galjonsfigur/gainer/README.md

GAINER
======

Software and hardware design resources for a sensor I/O module made
by Shigeru Kobayashi Takanori Endo Katsuhiko Harada and Shosei Oishi.

Contains:

- CY8C29466 PSoC GAINER firmware source code
- GAINER Flash library + source code
- GAINER Processing library (works only on very old version of Processing software) + source code
- GAINER Max/MSP library + source code
- GAINER PureData library + source code
- GAINER hardware design
- Eagle schematics for various projects
