galjonsfigur/gainer/hardware/gainer_v1/gainer_v1_bom.xls

GAINER I/O module parts list
version | 1.0.0
date | 2006.2.27
 | manufacturer | description | product | specification | part number | price | quantity | subtotal | comments
F1 | Littelfuse Inc | thermister PTC | 1206L025YRT | 15V, 0.25A | F2110CT-ND | 0.70 | 1 | 0.70
L1 | Steward | ferrite chip beads | MI0805K400R-10 | 1.5A, 40ohm | 240-2389-1-ND | 0.88 | 0.1 | 0.09 | 1/10
IC1 | Cypress | microcontroller | CY8C29466-24PXI |  | 428-1586-ND | 8.78 | 1 | 8.78
IC2 | FTDI | USB-to-UART bridge | FT232RL |  | 619-604-00043 (http://www.mouser.com/index.cfm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) | 4.50 | 1 | 4.50 | at Mouser Electronics, Inc.
C1, C4, C5 |  | ceramic capacitor |  | 0.1uF, 50V | 399-4151-ND | 0.16 | 3 | 0.48
C2 |  | ceramic capacitor |  | 0.01uF, 50V | 399-4150-ND | 0.16 | 1 | 0.16
C3 |  | electrolytic capacitor |  | 10uF, 25V | 493-1057-ND | 0.20 | 1 | 0.20
R1, R2 |  | resistor |  | 330ohm, 1/6W | 330EBK-ND | 0.26 | 0.4 | 0.10 | 2/5
LED1, LED2 |  | LED |  | 3mm | HLMP1790-ND | 0.34 | 2 | 0.68 | choose any color as you like :)
S1 | Omron | tact switch | B3F-1005 | 6mm | SW793-ND | 0.28 | 1 | 0.28
X1 |  | USB type B connector |  |  | 151-1081-ND | 0.73 | 1 | 0.73
 |  | IC socket |  | 28pin, 300mil | 571-3902619 | 0.20 | 1 | 0.20 | at Mouser Electronics, Inc.
 |  | single row header |  | 14pin * 2 | 575-101641 | 5.46 | 0.5 | 2.73 | 1/2, at Mouser Electronics, Inc.
PCB |  | PCB board |  | GAINER v1.0.0 |  | 42.00 | 0.167 | 7.00 | 1/6, at OLIMEX Ltd.
 |  |  |  |  |  |  | total | 26.63
NOTES
The price above does not include tax and shipping cost.
