galjonsfigur/gainer/(commit log)

2005-10-22 baseline version for the sourceforge CVS server
    [gainer_v1.brd, gainer_v1.sch]
2005-11-08 modified to add error checking for invalid commands
    [config_a.c, main.c]
2005-11-12 * make pull-down default (was pull-up) for digital inputs * fixed bugs about message analog input (continuous mode)
    [config_a.c]
2005-11-15 modified to fix following bugs: * 'A' commenad doesn't work correctly * order of analog inputs is inverted
    [config_a.c]
2005-11-22 changed drive mode of P1[5] from PullUp to PullDown to fix bug id 1362787
    [bootloaderconfig.asm]
2005-11-22 updated to fix the following bugs
    1362787: bootloader function won't work
    1358730: return charactors for button
2005-11-22 updated to fix the following bugs
    1363485: gainer module accepts broken commands
    1363459: gainer module stop responding at high traffic
    [config_a.c, config_b.c, gainer_common.h, main.c]
2005-11-23 * added WaitForBriefSpells() * reverted default configuration from C0 to C1
    [main.c]
2005-11-30 * changed configuration command from 'Cx' to 'KONFIGURATION_x' * implemented configuration 2 and 3 * modified PWM configuration * minor code fixing
    [config_a.c, config_b.c, gainer_common.h, main.c]
2005-12-01 * moved GET_DIN_* and SET_DOUT_* from gainer_common.h * fixed bug about 'i' command
    [config_a.c]
2005-12-08 this will be the second trial
    [gainer_v1.brd, gainer_v1.sch]
2005-12-10 modified the width of the polygon for the copper pour from 0 mils to 10 mils
    since made with 0 mils line width Eagle creates enormous useless gerbers
    (from OLIMEX)
    [gainer_v1.brd]
2005-12-10 * fixed isolate value of copper pour to 10 mils * modified silk a little bit
    [gainer_v1.brd, gainer_v1.sch]
2005-12-12 * added verbose mode * added config 4 (ain = 8, aout = 8) * changed PWM freq of config_a from 50Hz to 1000Hz
2005-12-12 added configuration 7 and 8 * configuration 7 is not implemented * configuration 8 has bugs...
    [config_c.c, config_d.c, gainer_common.h, main.c]
2005-12-16 * implemented 4 CapSense inputs * fixed bugs of the previous version
    [config_d.c]
2005-12-19 implemented configuration 7 (LED matrix control)
2006-01-03 modified to use FTDI FT232RL
    [gainer_v1.brd, gainer_v1.sch]
2006-01-04 updated for OLIMEX
    [gainer_v1.brd]
2006-01-14 updated a little bit for OLIMEX
    [gainer_v1.sch]
2006-01-18 modified to use passive devices instead of surface mount devices
    [gainer_v1.brd, gainer_v1.sch]
2006-01-31 modified to use passive components
    [gainer_v1.brd, gainer_v1.sch]
2006-02-06 modified silks and patterns a little bit for v1.00
    [gainer_v1.brd, gainer_v1.sch]
2006-02-20 updated for v1.0.0/8 * replaced software reset with just changing configuration * added '?' command to support version check
    [main.c]
2006-03-01 modified to handle very short pulse for analog inputs
    [config_a.c, main.c]
2006-03-02 modified to do UART_bErrCheck() to check Rx buffer
2006-03-07 modified to fix the following bug: [1441410] I/O module stop working after sending 'Q' in C8
    [config_d.c]
2006-03-13 modified to fix the following bug: [1448584] I/O module drops subsequent commands http://sourceforge.net/tracker/index.php?func=detail&aid=1448584&group_id=147670&atid=769110
    special thanks to Ganesh:
    http://www.psocdeveloper.com/forums/viewtopic.php?p=8582
    [config_a.c]
2006-03-14 + implemented 'adin sampling mode'
    + modified to reduce total binary size
    * replace 'switch-case' with 'if'
    * unified duplicated code portions
    [config_a.c]
2006-03-15 baseline version for CVS
    [gainer_v1_bom.xls]
2006-03-15 added description about 'M' command
    [io-module_protocol.xls]
2006-03-15 + fixed the following bug: [1450108] dout won't work in config 1 and 2
    + replaces 'switch-case' statement with 'if-elif' statement to reduce object size
    [config_a.c]
2006-03-15 repleced local implementation to put error strings with PutErrorStringToReplyBuffer()
    [config_b.c, config_c.c]
2006-03-15 + repleced local implementation to put error strings with PutErrorStringToReplyBuffer()
    + implemented 'T' command to change sensitivity for capasitive sensing inputs
    [config_d.c]
2006-03-15 + added 'T' command + added rows to show availability of commands in each configuration
    [io-module_protocol.xls]
2006-03-22 modified to fix a bug about touch sensitivity handling
    [config_d.c]
2006-03-24 modified to do not use non standard drill size (32mil) for OLIMEX Ltd. * C1 * C2 * C4 * C5
    [gainer_v1.brd, gainer_v1.sch]
2006-03-24 added 'GAINER v1'
    [gainer_v1.brd]
2006-03-27 replaced UART_x modules with single UART
    [config_a.c, config_b.c, config_c.c, config_d.c, main.c]
2006-03-30 modified to use a function pointer to main functions instead of using switch-case each time
2006-04-05 added descriptions of basic transactions * configuration * version information query
    [io-module_protocol.xls]
2006-04-17 added description about 'a' command in configuration 7
    [io-module_protocol.xls]
2006-05-15 レポジトリ作り。 基本的に必要そうなファイルを入れてみただけ
2006-05-16 シリアルポートとgainerのブリッジ製作中。 とりあえずガワだけ。
2006-05-17 changed LED brightness value from 8bit to 4bit
2006-05-19 絶賛ガワ工事進行中
2006-05-23 * replaced bContinuousAinRequested with bGetAinRequested * repleced bContinuousAinMask wirh bGetAinChannelMask
    [config_b.c, config_c.c, config_d.c, gainer_common.h]
2006-05-23 * replaced bContinuousAinRequested with bGetAinRequested * repleced bContinuousAinMask wirh bGetAinChannelMask * modified version strings from 1.0.0.14 to 1.0.0.15
    [main.c]
2006-05-23 * replaced bContinuousAinRequested with bGetAinRequested * repleced bContinuousAinMask wirh bGetAinChannelMask * modified handle_ain_event() and send_ain_values()
    [config_a.c]
2006-05-27 modified desrciption of 'a' command for configuration 7 * was 8bit per port * now 4bit per port
    [io-module_protocol.xls]
2006-05-28 Flashライブラリ追加
2006-05-28 package名をgainerに変更
2006-05-28 pdpをgainerにリネーム
2006-05-28 WIN32: Serial sending is OK implemented following methods Verbose configuration LEDOn LEDOff sendSerial
2006-06-11 指定したCOMポートが見つからなかったことを ログに出力
2006-06-14 modified to disconnect PWM8 modules in configuration 1 and 2 to fix the following bug: 0. connect an I/O module 1. enter configuration 1 -> dout 0~3 works 2. reboot by sending 'Q' command 3. enter co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
    [config_a.c]
2006-07-01 エラーメッセージ: specified port was not found... が正常起動時も表示されていた不具合を修正
2006-07-08 コマンド文字列中の16進数を大文字に変更(*.as) 各flaファイルのドキュメントレベルクラスパスの変更(*.fla) swfのリビルド(*.swf)
2006-07-10 Added the new project "funnel" to hardware. The funnel is a code name for a gainer I/O module with wireless connection capability.
    The funnel is consisting of the following key components:
    * CY8C29466-24SXI
    * KC Wirefree KC21 Bluetooth module
    [funnel.sch]
2006-07-26 initial design of the "funnel" i/o module * implemented initial design * added board file (.brd)
    [funnel.brd, funnel.sch]
2006-07-26 modified symbol design to shrink size of the regulator
2006-07-31 updated to do not use airways :)
    special thanks to: genie
    [funnel.brd, funnel.sch]
2006-08-30 ・アナログポートへの出力時に小数点以下切捨て ・ampGainAGND,ampGainDGND追加 ・MODE7とscanLine,scanMatrix追加
2006-08-30 * added bridges folder * added FET_bridge (.sch and .brd)
    [FET_bridge.brd, FET_bridge.sch]
2006-09-04 * modified silk on component side a little bit * added silk on solder side
    [FET_bridge.brd]
2006-09-04 added for GerbMerge to make order (to EzPCB)
    [FET_bridge_layout.cfg]
2006-09-12 scanLineのバグ修正
2006-09-12 8x8LEDマトリックスサンプル Flash8以降
2006-09-13 added experimental modules * RPR-220_board.* * psoc_module.* * power_module.* * bluetooth_module.*
    [RPR-220_board.brd, RPR-220_board.sch, bluetooth_module.brd, bluetooth_module.sch, power_module.brd, power_module.sch, psoc_module.brd, psoc_module.sch]
2006-09-14 Gainerを2つ使用しての16x8LEDMatrixサンプル 要WebCam,Flash8
2006-11-16 added "base" project for baseboard development
    [h-bridge.brd, h-bridge.sch]
2007-01-03 updated a little bit to fit actual pin layout
2007-01-03 updated to save space in schematics
2007-01-03 added cookbook (baseline version)
    [ain0_cds.sch, ain_acceleration_sensor.sch, ain_cds.sch, ain_distance_sensor.sch, ain_pot.sch, aout_dc-motor.sch, aout_full_color_led.sch, aout_led.sch]
2007-01-09 added following files: * custom.* * gainer_api.* * gainer_ports.h
    NOTE: still won't work
    [main.c]
2007-01-11 modified a lot to implement features (still won't work)
    [main.c]
2007-01-12 remap修正
2007-01-17 cdsと加速度センサのサンプル
2007-01-18 リファクタリング
2007-01-18 基本サンプル追加
2007-01-19 コメントの用語を統一
2007-01-19 コメント修正
2007-01-21 ワークショップで使用したクラスにコメント追加
2007-01-26 * implemented output functions * still doesn't work as expected * serial command handlers are not implemented
    [main.c]
2007-02-11 * modified to fit protocol http://gainer.cc/forum/index.php?topic=134.msg508#msg508
    * fixed bugs about command echo
    [main.c]
2007-02-13 fixed bugs about ADC * port 0~7 should work for AIN_ADC and DIN_PULL_DOWN * other modes have been not tested
    [main.c]
2007-02-15 added 'wireless' * a prototype for Gainer v1.5 * designed to use with a ZigBee module (ZIG-100B)
    [wireless.brd, wireless.sch]
2007-02-17 mx.utils.Delegateを使用しないバージョン
2007-02-18 Delegateを使わないよう修正
2007-07-25 added matrix-led.lbr
2007-07-28 fix demo.as and demo.mxml add demo.swf move from examples\flex2 to root directory add compile environment sample file
2007-08-08 added schematics for the Gainer Book's cookbook section
    [ain0_cds.sch, ain_acceleration_sensor.sch, ain_cds.sch, ain_distance_sensor.sch, ain_flex_sensor.sch, ain_motion_sensor.sch, ain_photo_reflector.sch, ain_piezo_element.sch]
2007-08-08 * fixed bug about the XRES pin (was connected to the SMP pin) * modified to route +5V and GND to the input side
    [gainer_v1.brd, gainer_v1.sch]
2007-08-09 modified to connect to din 0 instead of ain 0 to remove the pull down resistor
    [ain_motion_sensor.sch]
2007-09-08 added the following schematics * ain_sw.sch * ain_sw_pulldown.sch * led.sch * led_sw.sch
    updated the following schematics for the Gainer book
    * ain_pot.sch
    * aout_led.sch
    * din_sw.sch
    * dout_led.sch
    [ain_pot.sch, ain_sw.sch, ain_sw_pulldown.sch, aout_led.sch, din_sw.sch, dout_led.sch, led.sch, led_sw.sch]
2007-09-29 added schematics for "+GAINER"
    [juke_phone_inputs.sch, juke_phone_motor.sch, processing_sketch04.sch, processing_sketch05.sch, works_compass.sch, works_fuurin.sch, works_genkidama.sch, works_kuukiire.sch]
2007-09-29 * added ambient_device.sch for "ambient device" * added aout_led_sync.sch * fixed a bug in juke_phone_inputs.sch
    [ambient_device.sch, aout_led_sync.sch, juke_phone_inputs.sch]
2007-10-04 fixed bugs and replaced resistor symbol for "+GAINER"
    [ain_acceleration_sensor.sch, ain_cds.sch, ain_flex_sensor.sch, ain_photo_reflector.sch, ain_piezo_element.sch, ain_pot.sch, ain_sw_pulldown.sch, ambient_device.sch]
2007-10-15 updated for the final version of "+GAINER"
    [ain_distance_sensor.sch, aout_vibration_motor.sch, led_sw.sch]
2007-10-21 かきなおし
2007-10-21 ポート自動取得 クライアントがいなくなったらリブート
2007-10-21 ポート名は自動で取得するので、デフォルトでは指定しない
2007-10-21 Gainer確認用の文字列を"?1."までに変更
2007-10-22 RXTXライブラリをロックなしのバージョンへ置き換え
2007-10-31 入力ポートの配列の初期化時にデフォルト値を設定しておくよう変更
2008-01-22 added experimental wireless version mainly use DIP components: * wireless_dip.sch * wireless_dip.brd
    [wireless_dip.brd, wireless_dip.sch]
2008-04-15 Repleced following files with the binary files from Processing 0135/Arduino 0010: * librxtxSerial.jnilib * RXTXcomm.jar
2008-04-15 Repleced following files with the binary files from Processing 0135/Arduino 0010: * rxtxSerial.dll * RXTXcomm.jar
2008-07-10 modified to use a ring buffer for RX instead of a command buffer by UART user module
    NOTE: boot.tpl is modified to fake PSoC Designer v4.4
    should be update correctly to support HI-TECH
    [bootloader.c, config_a.c, config_b.c, config_c.c, config_d.c, gainer_common.h, main.c]
2008-07-10 add lowLevelVerbose of class variable and add function for skip trace command
2008-07-14 removed obsoleted firmware/hardware projects
    [FET_bridge.brd, FET_bridge.sch, FET_bridge_layout.cfg, RPR-220_board.brd, RPR-220_board.sch, bluetooth_module.brd, bluetooth_module.sch, funnel.brd]
2008-08-21 0144に対応
2008-09-29 * modified to reflect changes for +GAINER 2nd * added Gainer logo for EAGLE
    [works_compass.sch]
2009-03-14 added new samples for workshops in AS2
2009-03-14 added new samples and updated existing samples (button and LED) for workshops
2009-03-14 replaced with LED_aout_mouse.*
2009-03-14 removed unwanted trace() call
2009-03-15 added new samples for workshops
2018-10-28 Changed directory structure
    [ain0_cds.sch, ain_acceleration_sensor.sch, ain_cds.sch, ain_distance_sensor.sch, ain_flex_sensor.sch, ain_motion_sensor.sch, ain_photo_reflector.sch, ain_piezo_element.sch]
